SpaceBrainCircuits/MidiVolts1.2/MidiVolts V1.2 Schematic.pdf

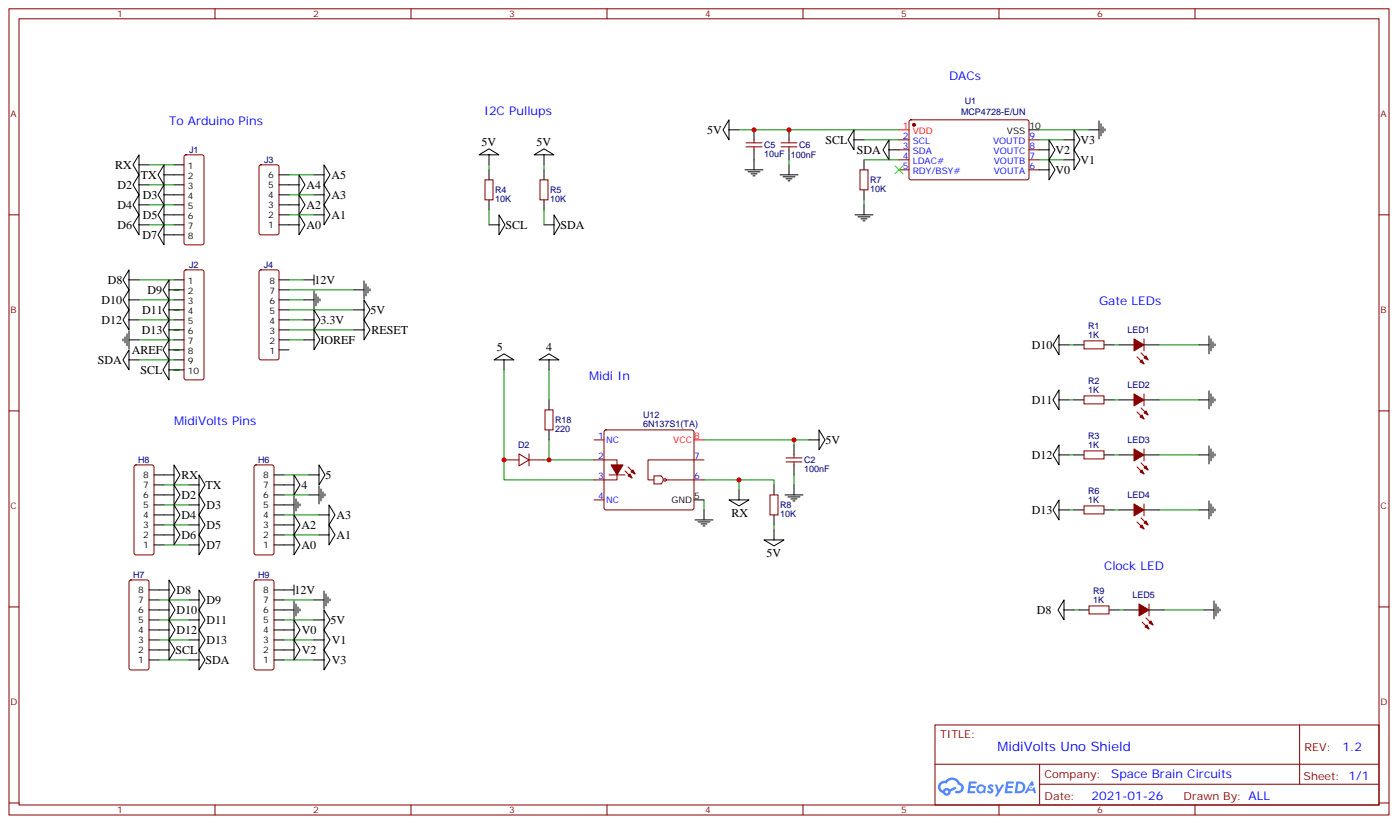
[picture p1: page 1]

Company: Space Brain Circuits
