SpaceBrainCircuits/MidiVolts1.2/MidiVoltsCalibration/Calibration Guide.pdf

# MidiVolts Arduino Uno Shield Calibration Guide

## First Step: Upload MidiVoltsCalibration

With the MidiVolts shield off, please upload the MidiVoltsCalibration Arduino Sketch to your Arduino Uno. Once finished, place MidiVolts shield onto Arduino Uno,
and match the jumpers
from Pitch CV to Calibration CV as shown below.
Please verify the pins are connected properly.

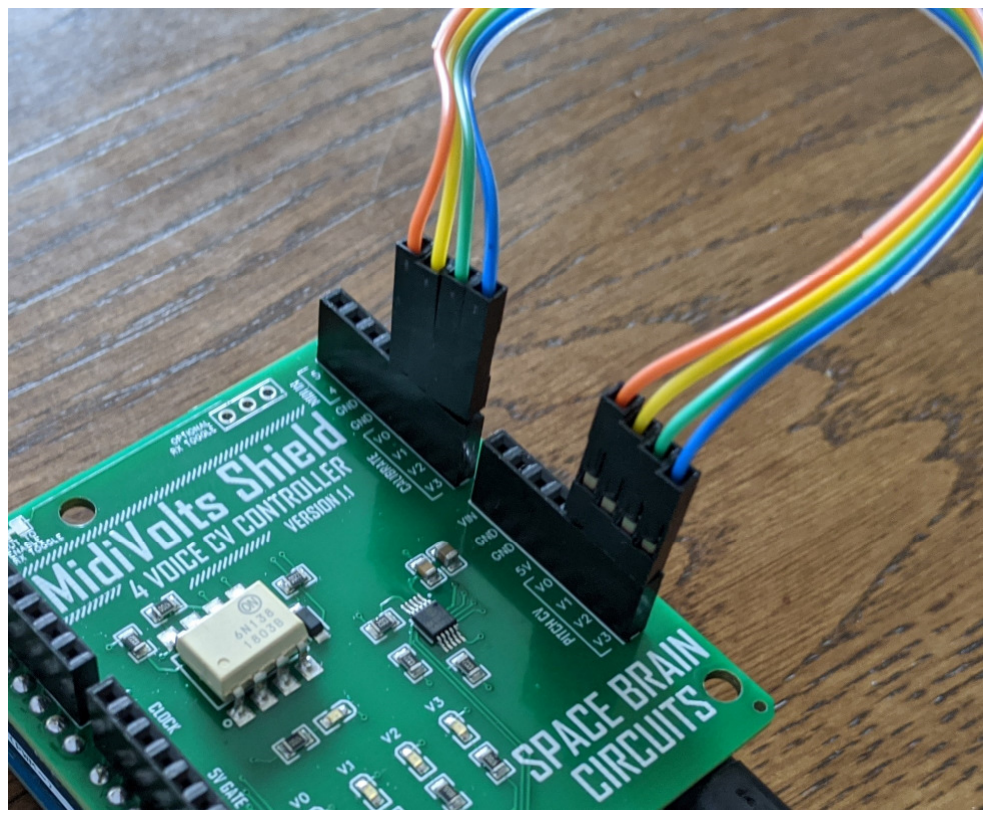
[picture p10: figure]

## Second Step: Open Serial Terminal

Open Serial Monitor and press clear output.

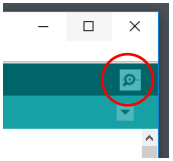
[picture p11: figure]

Once Serial Monitor is blank, press the Arduino reset momentary button and wait for the script to finish running.

## Third Step: Copy Results

Copy the results from the Serial Monitor window, by pressing Cntrl A (Cmd A for Mac) and Control C (Cmd C for Mac) for copy.

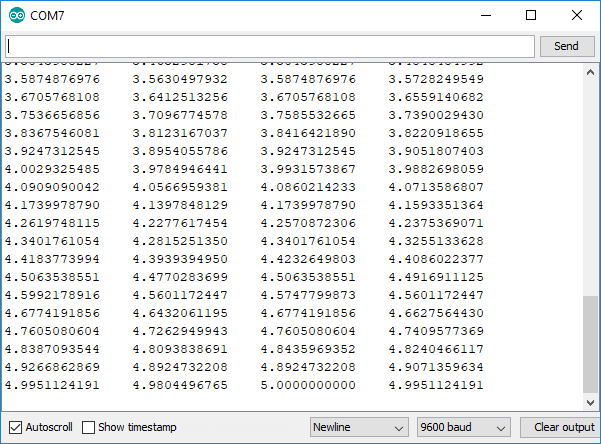
[picture p12: figure]
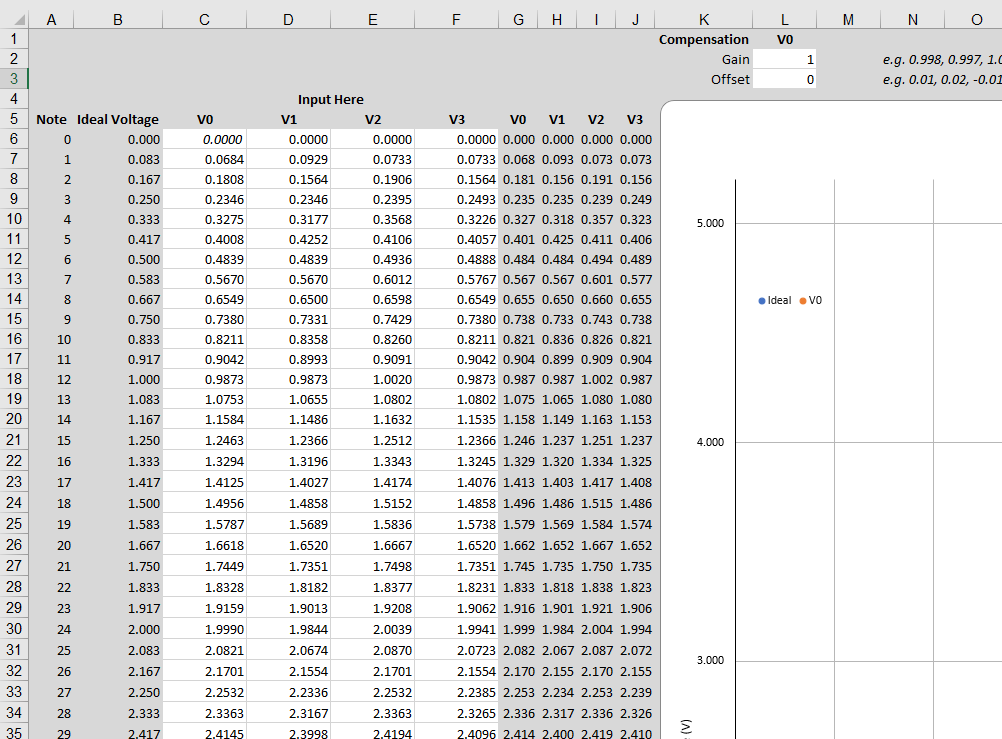
[picture p13: figure]
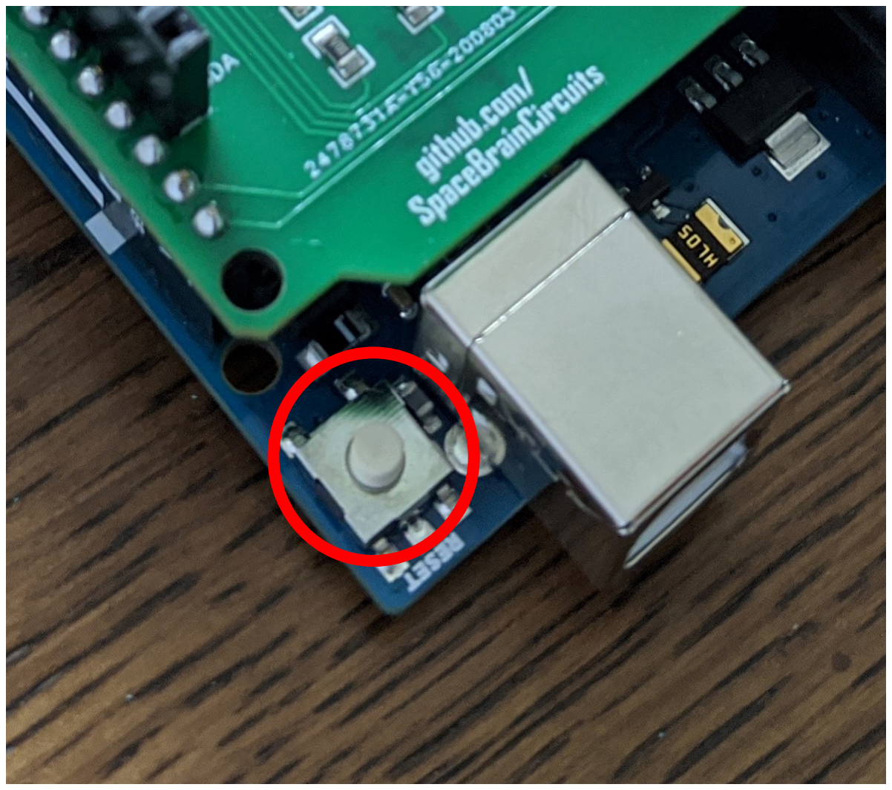
[picture p14: figure]

Please email spacebraincircuits@gmail.com for any questions or issues! I am more than happy to help!

## Fourth Step: Calibration Sheet

Paste values into the Calibration Spreadsheet in cell C6 as shown below.

Pitch CV increments 0.083 Volts per note. The MCP4728 has very accurate voltage scaling, however, there are discrepancies due to internal opamps. This is called Offset and Gain error. These values can be adjusted to properly calibrate the Pitch CV scaling by slightly adjusting these values in code. Please see README for Pitch CV theory and methodology for calibrating your MidiVolts shield using a multimeter. Multimeter calibration is most accurate method but also the most time consuming. The method in this document will be the fastest, however further adjustments may be necessary for perfect scaling.

## Fifth Step: Analysis

Based on data that was inserted into spreadsheet, the graphs can be used to calibrate the DAC to scale much more accurately by adjusting the Gain and Offset error. The blue data signifies perfect pitch to CV scaling. The orange is data that came from the MidiVoltsCalibration script. The goal is to match the orange and blue data as much as possible using the Gain and Offset compensation at the top of the spreadsheet.

Adjust these values very minimally to see the effect. In most cases, a range of 1.002 or 0.998 is appropriate for gain adjustment. See numbers to the right as a starter point. Do this process for each Voice (V0-V3).

## Sixth Step: Assign Values to MidiVolts

Place this data in the setup method on the MidiVolts sketch as shown below.

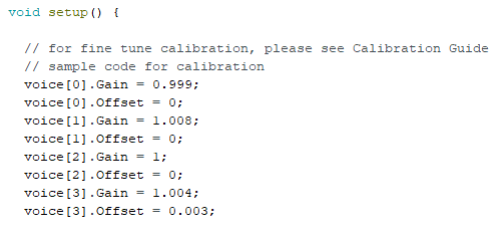
[picture p15: figure]
