SpaceBrainCircuits/MidiVolts1.2/MidiVoltsCalibration/MidiVolts Calibration V1.2.xlsx

 |  |  |  |  |  |  |  |  |  | Compensation | V0 |  | Compensation | V1 | Compensation | V2 | Compensation | V3
 |  |  |  |  |  |  |  |  |  | Gain | 1 | e.g. 0.998, 0.997, 1.002 | Gain | 1 | Gain | 1 | Gain | 1
 |  |  |  |  |  |  |  |  |  | Offset | 0 | e.g. 0.01, 0.02, -0.01 | Offset | 0 | Offset | 0 | Offset | 0
 |  | Input Here
Note | Ideal Voltage | V0 | V1 | V2 | V3 | V0 | V1 | V2 | V3
0 | 0.000 | paste here |  |  |  | #VALUE! | 0.000 | 0.000 | 0.000
1 | 0.083 |  |  |  |  | 0.000 | 0.000 | 0.000 | 0.000
2 | 0.167 |  |  |  |  | 0.000 | 0.000 | 0.000 | 0.000
3 | 0.250 |  |  |  |  | 0.000 | 0.000 | 0.000 | 0.000
4 | 0.333 |  |  |  |  | 0.000 | 0.000 | 0.000 | 0.000
5 | 0.417 |  |  |  |  | 0.000 | 0.000 | 0.000 | 0.000
6 | 0.500 |  |  |  |  | 0.000 | 0.000 | 0.000 | 0.000
7 | 0.583 |  |  |  |  | 0.000 | 0.000 | 0.000 | 0.000
8 | 0.667 |  |  |  |  | 0.000 | 0.000 | 0.000 | 0.000
9 | 0.750 |  |  |  |  | 0.000 | 0.000 | 0.000 | 0.000
10 | 0.833 |  |  |  |  | 0.000 | 0.000 | 0.000 | 0.000
11 | 0.917 |  |  |  |  | 0.000 | 0.000 | 0.000 | 0.000
12 | 1.000 |  |  |  |  | 0.000 | 0.000 | 0.000 | 0.000
13 | 1.083 |  |  |  |  | 0.000 | 0.000 | 0.000 | 0.000
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
